VeikkoAJ/Ebike-Battery-Range-Estimator/pics/fullBike.jpg

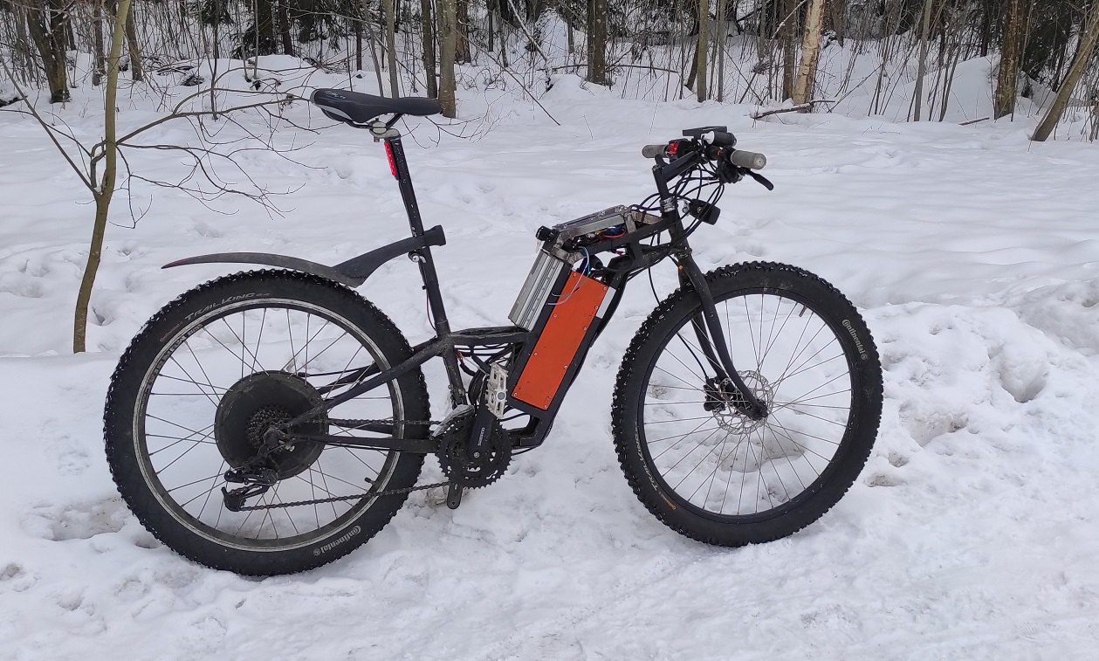
pics/fullBike.jpg
