VeikkoAJ/Ebike-Battery-Range-Estimator/EbikeBatteryRangeEstimator/EbikeBatteryRangeEstimator.ino

// Intelligent Ebike battery capacity and range estimator
// Ebike nominal voltage 48V 
// LCD mounted sideways
// More information at: https://github.com/VeikkoAJ/Ebike-Battery-Range-Estimator
// Version 1.1.5 released: 31.1.2021
// Veikko Jaaskelainen

extern "C"{
  #include "CellCapacity.h"
  #include "CustomChar.h"
}

#include <Wire.h>
#include <SoftwareSerial.h>
#include <TinyGPS++.h>
#include <hd44780.h>                  
#include <hd44780ioClass/hd44780_I2Cexp.h>

const int debug = 0; // Run voltage and lcd tests on startup
const int debugGps = 0; // enables serial communication to pc from gps
const int debugRange = 0; // debugging range estimation

// Schematic available at github
const int gpsTX = A2;
const int gpsRX = A1;
const int currentPin = A3;
const int voltagePin = A7;
const int lightSwitchPin = 12;
const int highBeamSwitchPin = 9;
const int lightDriverPin = 11;

SoftwareSerial gpsSerial(gpsTX, gpsRX);
TinyGPSPlus gps;
hd44780_I2Cexp lcd(0x27);

// current sensor logic (0 V = -30 A, 2.5 V = 0 A, 5 V = +30 A)
const float digitalToCurrent = 30.0 / (512.0); 
// current sensor calibration
const float currentShift = 0.24;
// main battery voltage divider
const float voltageLevelShift = 59.2 / 1023.0;

// size of the battery grid
const int bRows = 13;
const int bColumns = 3;
// Ampere hours of a single cell
const float cellCapacity = 2.6;
// Ampere hours of parallel cells
const float rowAh = (float) bColumns * cellCapacity;

// headlight levels, for the pwm-driven light
const int lowLight = 10;
const int highLight = 50;
const int fullLight = 255;

int currentLightValue = 0.0;
// light switch states
int lightState = 0;
int beamState = 0;

// logic for battery capacity measuring, true when: current  < 0.2
int standBy = 0; 
// depth of discharge, calculated from voltage
float vDOD = 0.0;
// depth of discharge. Calculated from voltage or iteratively from currentflow
float DOD = 0.0;
// state of charge. Given as a ratio of rowAh
float SOC = 0.0;
// current flow of the Ebike. With the current setup all current flows through the current meter.
float current = 0.0;
// main battery voltage, aquired from the voltage divider.
float voltage = 0.0;
// estimation of the range left in the batterypack. in Km
int range = 0;

//range estimation averages
long rangeTimeSum = 0;
float rangeCurrentAverage = 0.0;
float rangeVelocityAverage = 0.0;
int rangeSumCount = 0;
// how many measurements for the range estimation
int rangeSumLimit = 20;

// velocity from the gps
float velocityKnots = 0.0;
// gps data logic
bool newGpsData = false; 

 // Current measuring interval
unsigned long currentMeasureMillis = 0;
unsigned long currentMeasureInterval = 1000;
 // Lcd Refresh rate
unsigned long lcdRefreshMillis = 0;
unsigned long lcdRefreshInterval = 1500;

// nice animation to check that the lcd and the frontlight both work.
void bootAnimation() {
  int animationStep = 80;
  for (int i = 255; i >= 0; i--) {
    delay(animationStep / 17);
    analogWrite(lightDriverPin, 255 - i);
    if (i % 17 == 0) {
      lcd.setCursor(i / 17, 0);
      lcd.write((char) 255);
      lcd.setCursor(i / 17, 1);
      lcd.write((char) 255);
    }
  }
  delay(300);
  for (int i = 0; i < 256; i++) {
    delay(animationStep / 17);
    float newLightValue = (255 - i ) > lowLight ? (255 - i) : lowLight;
    analogWrite(lightDriverPin, newLightValue);
    if (i % 17 == 0) {
      lcd.setCursor(i / 17, 0);
      lcd.write('=');
      lcd.setCursor(i / 17, 1);
      lcd.write('=');
    }
  }
  delay(100);
  for (int i = 0; i < 256; i++) {
    delay(animationStep / 17);
    if (i % 17 == 0) {
      lcd.setCursor(i / 17, 0);
      lcd.write(' ');
      lcd.setCursor(i / 17, 1);
      lcd.write(' ');
    }
  }
}

// sets the custom characters to lcd memory
void setCustomChars() {
  const int numbers[8] = {0,2,4,5,6,7,8,9};
  byte customChar[8];
  for (int i = 0; i < 8; i++) {
    getCustomCharPattern(numbers[i], customChar);
    lcd.createChar(i, customChar);
  }
} 

// prints a two digit value sideways. 
void printReMappedString(char inputText[], int column) {
  if (column > 15 || column < 0) {
    return;
  }
  unsigned char text[2];
  remapText(inputText, text);
  lcd.setCursor(column, 1);
  lcd.write(byte(text[0]));
  if (strlen(inputText) < 2) {
    return;
  }
  lcd.setCursor(column, 0);
  lcd.write(byte(text[1]));
}

// sets the PWM driven light to correct state
void setLights() {
 // light state detection
  int newLightValue;
  lightState = digitalRead(lightSwitchPin);
  beamState = digitalRead(highBeamSwitchPin);
  // set front light to current level
  if (lightState == 1 && beamState == 1) {
    newLightValue = fullLight;
    analogWrite(lightDriverPin, fullLight);
  } else if (lightState == 1) {
    newLightValue = highLight;
  } else {
    newLightValue = lowLight;
  }
  if (currentLightValue == newLightValue) {
    return;
  }
  if (newLightValue < currentLightValue) {
    for (int i = currentLightValue; i >= newLightValue; i--) {
      analogWrite(lightDriverPin, i);
      delay(5);
    }
    currentLightValue = newLightValue;
    return;
  }
  if (newLightValue > currentLightValue) {
    for (int i = currentLightValue; i <= newLightValue; i++) {
      analogWrite(lightDriverPin, i);
      delay(5);
    }
    currentLightValue = newLightValue;
    return;
  }

}

// measures voltage and current, current is locked to > 0
void measureVA() {
  float tempCurrent = 0.0;
  float tempVoltage = 0.0;
  const int iterations = 50;
  for (int i = 0; i < iterations; i++) {
    tempCurrent = tempCurrent + (analogRead(currentPin) - 512.0) * digitalToCurrent + currentShift;
    tempVoltage = tempVoltage + analogRead(voltagePin) * voltageLevelShift;
    delay(1);
  }
  tempCurrent = tempCurrent / (float) iterations;
  current = tempCurrent > 0 ? tempCurrent : 0.0; // prevents negative current (negative current is useless, but can occur with motor braking)
  voltage = tempVoltage / (float) iterations;
}

// Sets the depth of discharge according to the predefined discharge graph.
void setVDOD(float v) {
  int mAh = 0;
  int x = v * 1000.0 /  bRows;
  mAh = getCapacity(x, (int) (cellCapacity * 1000));
  vDOD = (float) mAh * bColumns / 1000.0;
}

// Sets the depth of discharge either directly or as an average, to remove flickering when the bike is on standby.
void setDOD() {
  if (current < 0.2) {
    setVDOD(voltage);
    if (standBy) {
      DOD = (DOD * 7 + vDOD) / 8;
    } else {
      DOD = vDOD;
    }
    standBy = 1;
  };
  if (current > 0.5) {
     standBy = 0;
  }
}
// calculates average of used energy. Derives range left from used energy.
void setRangeEstimation(unsigned long timeInterval) {
  if (rangeSumCount < rangeSumLimit) {
    // summing
    if (debugRange) {
      current = 8.15;
      velocityKnots = 13.95;
      Serial.println(rangeSumCount);
    }
    rangeTimeSum += timeInterval;
    rangeVelocityAverage += velocityKnots;
    rangeCurrentAverage += current;
    rangeSumCount++; 
  } else {
    // estimation
    rangeSumCount = 0;
    float usedHours = (float) rangeTimeSum / 3600.0;
    float usedAh = rangeCurrentAverage / (float) rangeSumLimit * usedHours;
    float hoursLeft = (rowAh - DOD) / usedAh * usedHours;
    if (debugRange) {
      Serial.print("current=");
      Serial.print(rangeCurrentAverage / (float) rangeSumLimit);
      Serial.print(", used amp hours=");
      Serial.print(usedAh);
      Serial.print(", batt amp hours=");
      Serial.print((rowAh - DOD));
      Serial.print(", velocity=");
      Serial.print(rangeVelocityAverage * 1.852 /(float) rangeSumLimit);
      Serial.print(", time=");
      Serial.print(rangeTimeSum);
      Serial.print(", hours left=");
      Serial.print(hoursLeft);
    }
    float newRange = hoursLeft * rangeVelocityAverage * 1.852 / (float) rangeSumLimit;
    if (newRange < 0.0) {
      range = 0;
    } else if(newRange > 99.0) {
      range = 99;
    } else {
      range = newRange;
    }
    if (debugRange) {
      Serial.print(", range=");
      Serial.println(newRange);
    }
    // reset
    rangeSumCount = 0;
    rangeCurrentAverage = 0.0;
    rangeVelocityAverage = 0.0;
    rangeTimeSum = 0;
  }
}

// gets velocity from gps, uses TinyGPS library to parse nmea messages
void getGPSVelocity() {
  newGpsData = false;
  unsigned long chars;
  unsigned short sentences, failed;
  
  for (unsigned long start = millis(); millis() - start < 1000;) {
    while (gpsSerial.available() &&  millis() - start < 1000) {
      char c = gpsSerial.read();
      if (debugGps) {
        Serial.write(c);
      }
      if (gps.encode(c)) {
        newGpsData = true;
      }
    }
  }
  if (newGpsData) {
    velocityKnots = gps.speed.knots(); //change directly to km/h.
  }
  if (debugGps) {
    Serial.print("\n\nsatellites=");
    Serial.print("velocityKnots=");
    Serial.println(velocityKnots);
    Serial.println("\n\n");
  }
}

// main lcd printing logic
void refreshLCD() {
  lcd.clear();
  int printColumn = 0;
  // batterypack capacity bar
  if (SOC < 0.9) {
    for (int i = 0; i <= 10 - (int) (SOC * 10.0 + 1); i++) {
      lcd.setCursor(i, 0);
      lcd.write(" ");
      lcd.setCursor(i, 1);
      lcd.write(" ");
      printColumn = i;
    }
  }
  //middle half bar used to present 0.1-0.9 percent
  unsigned char middleSymbol;
  int decimalPercentage = int (SOC * 100.0) - int (SOC * 10) * 10;
  if (decimalPercentage < 3) {
    middleSymbol = ' ';
  }
  if (decimalPercentage <= 6) {
    middleSymbol = byte(0);
  }
  if (decimalPercentage > 6) {
    middleSymbol = (char) 255;
  }
  lcd.setCursor(printColumn + 1, 0);
  lcd.write(middleSymbol);
  lcd.setCursor(printColumn + 1, 1);
  lcd.write(middleSymbol);
  for (int i = printColumn + 2; i <= int (SOC * 10.0) + printColumn; i++) {
    lcd.setCursor(i, 0);
    lcd.write((char) 255);
    lcd.setCursor(i, 1);
    lcd.write((char) 255);
  }
  // divider
  lcd.setCursor(10, 0);
  lcd.write("|");
  lcd.setCursor(10, 1);
  lcd.write("|");
  // velocity
  char velocityText[3];
  if (velocityKnots > 0.0) {
    printReMappedString(itoa(velocityKnots * 1.852, velocityText, 10), 11);
  } else {
    printReMappedString(itoa(00, velocityText, 10), 11);
  }
  // range
  char rangeText[3];
  if (velocityKnots * 1.852 > 5.0) {
    printReMappedString(itoa(range, rangeText, 10), 12);
  } else {
    printReMappedString(itoa(99, rangeText, 10), 12);
  }
  //SOC
  char SOCText[3];
  if (SOC * 100 > 99.0) {
    printReMappedString(itoa(99, SOCText, 10), 14);
  } else {
    printReMappedString(itoa((int) SOC * 100.0, SOCText, 10), 14);
  }
  // cacacity  Ah * 10
  char capacityText[3];
  printReMappedString(itoa((int) (DOD * 10.0), capacityText, 10), 15);
  
  // divider (in wrong place!)
  lcd.setCursor(10, 0);
  lcd.write("|");
  lcd.setCursor(10, 1);
  lcd.write("|");
}


void setup() {
  pinMode(currentPin, INPUT);
  pinMode(voltagePin, INPUT);
  pinMode(lightSwitchPin, INPUT);
  pinMode(highBeamSwitchPin, INPUT);
  pinMode(lightDriverPin, OUTPUT);

  Serial.begin(115200);
  gpsSerial.begin(9600);
  if(debug || debugGps ||debugRange) {
    Serial.println("setting up");
  }
  
  // lcd setup
  int status;
  status = lcd.begin(16, 2);
  if(status) {
    hd44780::fatalError(status); // does not return
  }
 
  setCustomChars();
  //debug mode to display characters on lcd and test the voltage to capacity function
  if (debug) {
    lcd.print("DEBUG = 1");
    delay(200);
    lcd.clear();
    delay(200);
    // prints 1->15 numbers sideways to the screen
    for (int i = 0; i < 15; i++) {
      char text[3];
      printReMappedString(itoa(i, text, 10), i);
    }
    delay(1500);
    lcd.clear();
    delay(200);
    for (int i = 110; i > 76; i--) {
      voltage = (float) i / 2.0;
      current = 0.1;
      setVDOD(voltage);
      DOD = vDOD;
      SOC = 1.0 - vDOD / rowAh;
      refreshLCD();
      delay(200);
    }
    lcd.clear();
    lcd.print("DEBUG OVER");
    if (debug || debugGps || debugRange) {
      Serial.println("debug over");
    }
  }
  measureVA();
  setDOD();
  bootAnimation();  
}

void loop() {
  setLights();
  getGPSVelocity();
  //Reading gps data takes >1 second, so lightState is needed to recheck
  setLights();
  measureVA();
  setDOD();
  
  // current integration to used capacity
  if (millis() - currentMeasureMillis > currentMeasureInterval) {
    unsigned long measureTime = (millis() - currentMeasureMillis) / 1000;
    DOD = DOD - current * measureTime / 3600;
    SOC = 1.0 - (DOD / rowAh);
    setRangeEstimation(measureTime);
    currentMeasureMillis = millis();
  }
  
  // Screen refreshing. framerate: 0.66 Hz
  if (millis() - lcdRefreshMillis > lcdRefreshInterval) {
    refreshLCD();
    lcdRefreshMillis = millis();
  }
}
