VeikkoAJ/Ebike-Battery-Range-Estimator/EbikeBatteryRangeEstimator/CellCapacity.c

// values store as [mV, mA] pairs
// more information about how this table was generated can be found here:
// https://github.com/VeikkoAJ/Ebike-Battery-Range-Estimator
int voltageCapacityTable[99][2] = {
  {2703, 2600},
  {2753, 2574},
  {2824, 2548},
  {2970, 2522},
  {3224, 2496},
  {3316, 2470},
  {3373, 2444},
  {3417, 2418},
  {3453, 2392},
  {3478, 2366},
  {3496, 2340},
  {3511, 2314},
  {3523, 2287},
  {3534, 2260},
  {3544, 2234},
  {3552, 2207},
  {3560, 2181},
  {3567, 2155},
  {3573, 2129},
  {3580, 2101},
  {3586, 2074},
  {3591, 2047},
  {3596, 2021},
  {3601, 1995},
  {3606, 1969},
  {3610, 1943},
  {3615, 1915},
  {3619, 1889},
  {3623, 1863},
  {3627, 1835},
  {3631, 1806},
  {3634, 1777},
  {3636, 1751},
  {3639, 1721},
  {3642, 1692},
  {3645, 1663},
  {3648, 1636},
  {3651, 1609},
  {3654, 1583},
  {3658, 1554},
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
};

/*
 * Returns the capacity USED, to a given open circuit cell voltage
 * Calculates average between the 2 surrounding values
 */
int getCapacity(int voltage, int maxCapacity) {
    int mAh = 0;
    if (voltage < 2700) {
        mAh = maxCapacity;
    }
    if (voltage > 4200) {
        mAh =  0;
    }
    for (int i = 0; i < 99; i++) {
        if (voltage < voltageCapacityTable[i][0]) {
            if (i > 1) {
                mAh = ((voltageCapacityTable[i][1] + voltageCapacityTable[i - 1][1]) / 2);
                break;
            } else {
                mAh = voltageCapacityTable[i][1];
            }
        }
    }
  return mAh <= maxCapacity ? mAh : maxCapacity;
};
