VeikkoAJ/Ebike-Battery-Range-Estimator/(commit log)

2021-01-13 fixed duplicate main master branch
    [EbikeBatteryRangeEstimator.ino]
2021-01-27 Create BatteryVoltageChargeFunction
2021-01-27 changing voltage function
2021-01-28 working battery level indicator
